VittorioCoseglia/OverDrive/img/multisim.PNG

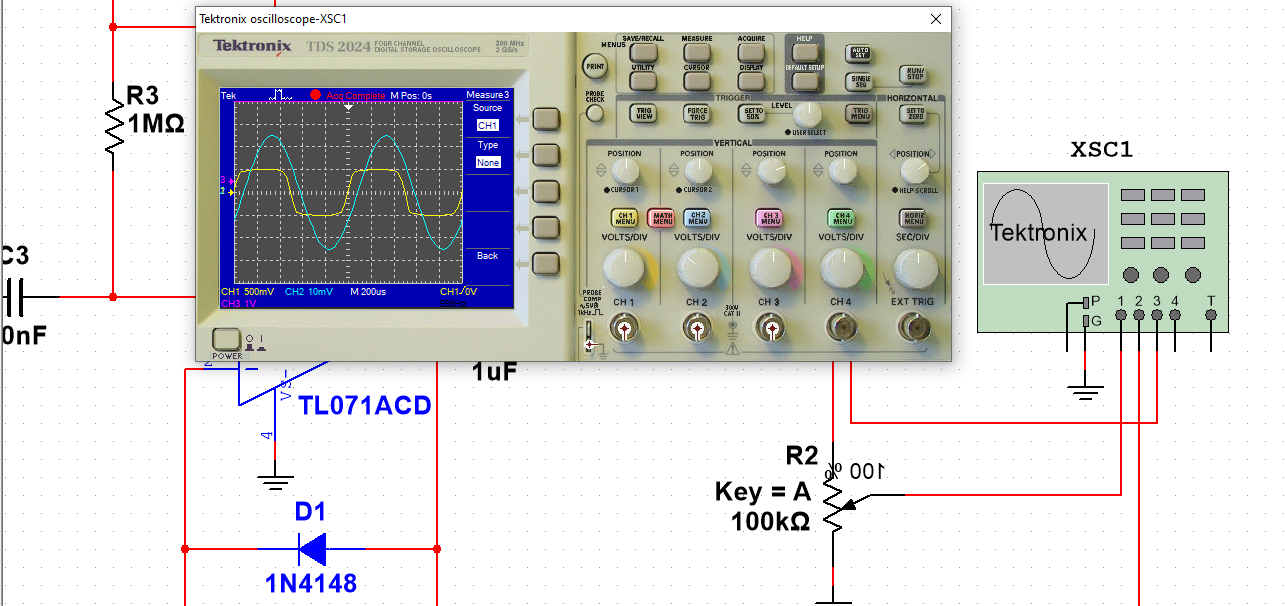
img/multisim.PNG
