VittorioCoseglia/OverDrive/docs/bom.md

# Bill of Materials 📑

> all of components are **THT**

_**The price factors in the quantity.**_
## Component List

| Reference | Qty | Value | Datasheet |
|---|---|---|---|
| 3PDT2 | 1 | 3PDT | |
| C1 | 1 | 470nF | |
| C2 | 1 | 1uF | |
| C3 | 1 | 220nF | |
| C4 | 1 | 100pF | |
| C5,C6 | 2 | 47uF | |
| D1 | 1 | LED | |
| D2,D3 | 2 | 1N4148 | [Datasheet](https://assets.nexperia.com/documents/data-sheet/1N4148_1N4448.pdf) |
| J1 | 1 | Barrel_Jack_MountingPin | |
| J2,J4 | 2 | NJ6TB-V | [Datasheet](https://www.neutrik.com/en/product/nj6tb-v) |
| R1 | 1 | 360 | |
| R2,R3,R6,R7 | 4 | 10k | |
| R4 | 1 | 1k | |
| R5 | 1 | 1M | |
| RV1 | 1 | LOG 100K | |
| RV2 | 1 | LOG 50K | |
| SW2 | 1 | 2pos_switch | [Datasheet](https://www.digikey.com/en/products/detail/c-k/OS102011MS2QS1/1981413) |
| U1 | 1 | TL071 | [Datasheet](http://www.ti.com/lit/ds/symlink/tl071.pdf) |
