VittorioCoseglia/OverDrive/Case/Pedal.step

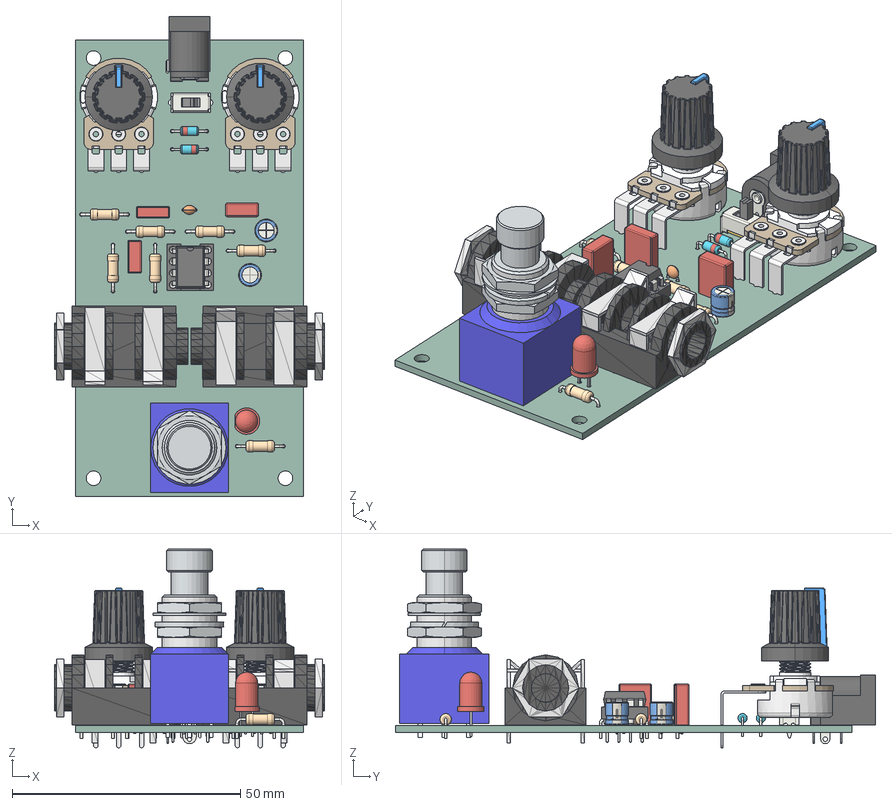
[picture p6: CAD file, 2026-10-29]
Case/Pedal.step
59.2 x 105.1 x 43.5 mm
Plastic_Body_1of2
Plastic_Body_2of2
PIN_01
PIN_03
PIN_02
Boner
NEUTRIKJK_2 x 2
NEUTRIKJK_3 x 2
NEUTRIKJK_4 x 2
NEUTRIKJK_5 x 2
NEUTRIKJK_6 x 2
NEUTRIKJK_7 x 2
NEUTRIKJK_8 x 2
NEUTRIKJK_9 x 2
NEUTRIKJK_10 x 2
NEUTRIKJK_11 x 2
NEUTRIKJK_12 x 2
NEUTRIKJK_13 x 2
NEUTRIKJK_14 x 2
NEUTRIKJK_15 x 2
NEUTRIKJK_16 x 2
NEUTRIKJK_17 x 2
NEUTRIKJK_18 x 2
NEUTRIKJK_19 x 2
NEUTRIKJK_20 x 2
NEUTRIKJK_21 x 2
NEUTRIKJK_22 x 2
NEUTRIKJK_23 x 2
NEUTRIKJK_24 x 2
NEUTRIKJK_25 x 2
NEUTRIKJK_26 x 2
R_Axial_DIN0207_L6.3mm_D2.5mm_P10.16mm_Horizontal x 7
D_DO-35_SOD27_P7.62mm_Horizontal x 2
User Library-Footswich_3PDT
CP_Radial_D5.0mm_P2.00mm x 2
C_Rect_L7.2mm_W2.5mm_P5.00mm_FKS2_FKP2_MKS2_MKP2
LED_D5.0mm
DIP-8_W7.62mm
DIP-8_W7.62mm_Socket
C_Rect_L7.2mm_W3.0mm_P5.00mm_FKS2_FKP2_MKS2_MKP2 x 2
RV16AF-41 x 2
knob x 2
C_Disc_D3.0mm_W2.0mm_P2.50mm
SW_Slide_SPDT_Straight_CK_OS102011MS2Q
Pedal_PCB
