VittorioCoseglia/OverDrive/PCB/3dmodels/knob.STEP

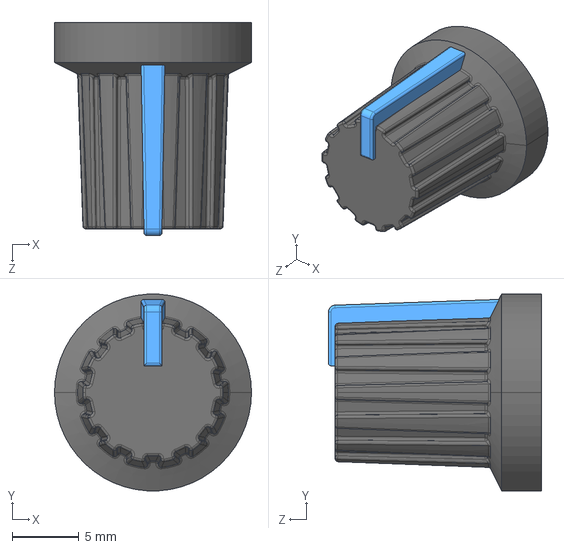
[picture p7: CAD file, 2026-10-29]
PCB/3dmodels/knob.STEP
14.8 x 14.8 x 16.0 mm
