VittorioCoseglia/OverDrive/Case/Case.STEP

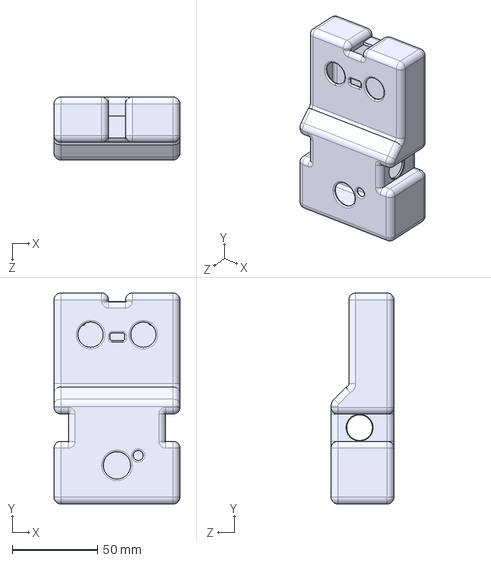
[picture p8: CAD file, 2026-10-29]
Case/Case.STEP
74.0 x 124.0 x 37.0 mm
