VittorioCoseglia/OverDrive/PCB/3dmodels/NEUTRIKJK.stp

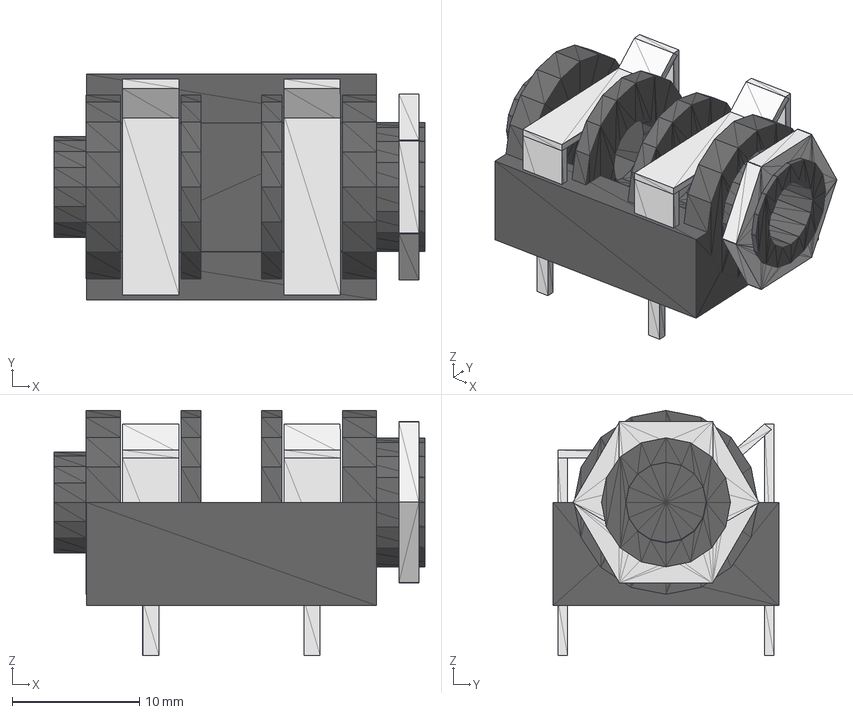
[picture p10: CAD file, 2026-10-29]
PCB/3dmodels/NEUTRIKJK.stp
29.2 x 17.8 x 19.3 mm
NEUTRIKJK_2
NEUTRIKJK_3
NEUTRIKJK_4
NEUTRIKJK_5
NEUTRIKJK_6
NEUTRIKJK_7
NEUTRIKJK_8
NEUTRIKJK_9
NEUTRIKJK_10
NEUTRIKJK_11
NEUTRIKJK_12
NEUTRIKJK_13
NEUTRIKJK_14
NEUTRIKJK_15
NEUTRIKJK_16
NEUTRIKJK_17
NEUTRIKJK_18
NEUTRIKJK_19
NEUTRIKJK_20
NEUTRIKJK_21
NEUTRIKJK_22
NEUTRIKJK_23
NEUTRIKJK_24
NEUTRIKJK_25
NEUTRIKJK_26
