VittorioCoseglia/OverDrive/PCB/3dmodels/User Library-Footswich_3PDT.step

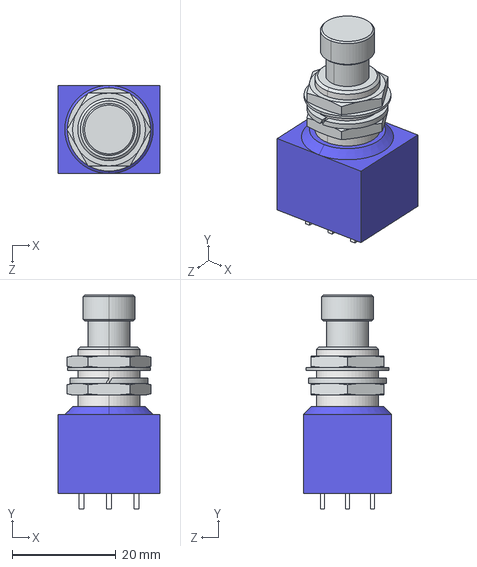
[picture p11: CAD file, 2026-10-29]
PCB/3dmodels/User Library-Footswich_3PDT.step
19.6 x 41.2 x 17.0 mm
