VittorioCoseglia/OverDrive/(list of files, cad)

Other CAD files:
Case/Case.SLDASM
Case/Case.SLDPRT
