VittorioCoseglia/OverDrive/PCB/Pedal.kicad_pcb

## KiCad design PCB/Pedal.kicad_pcb (2026-10-29)

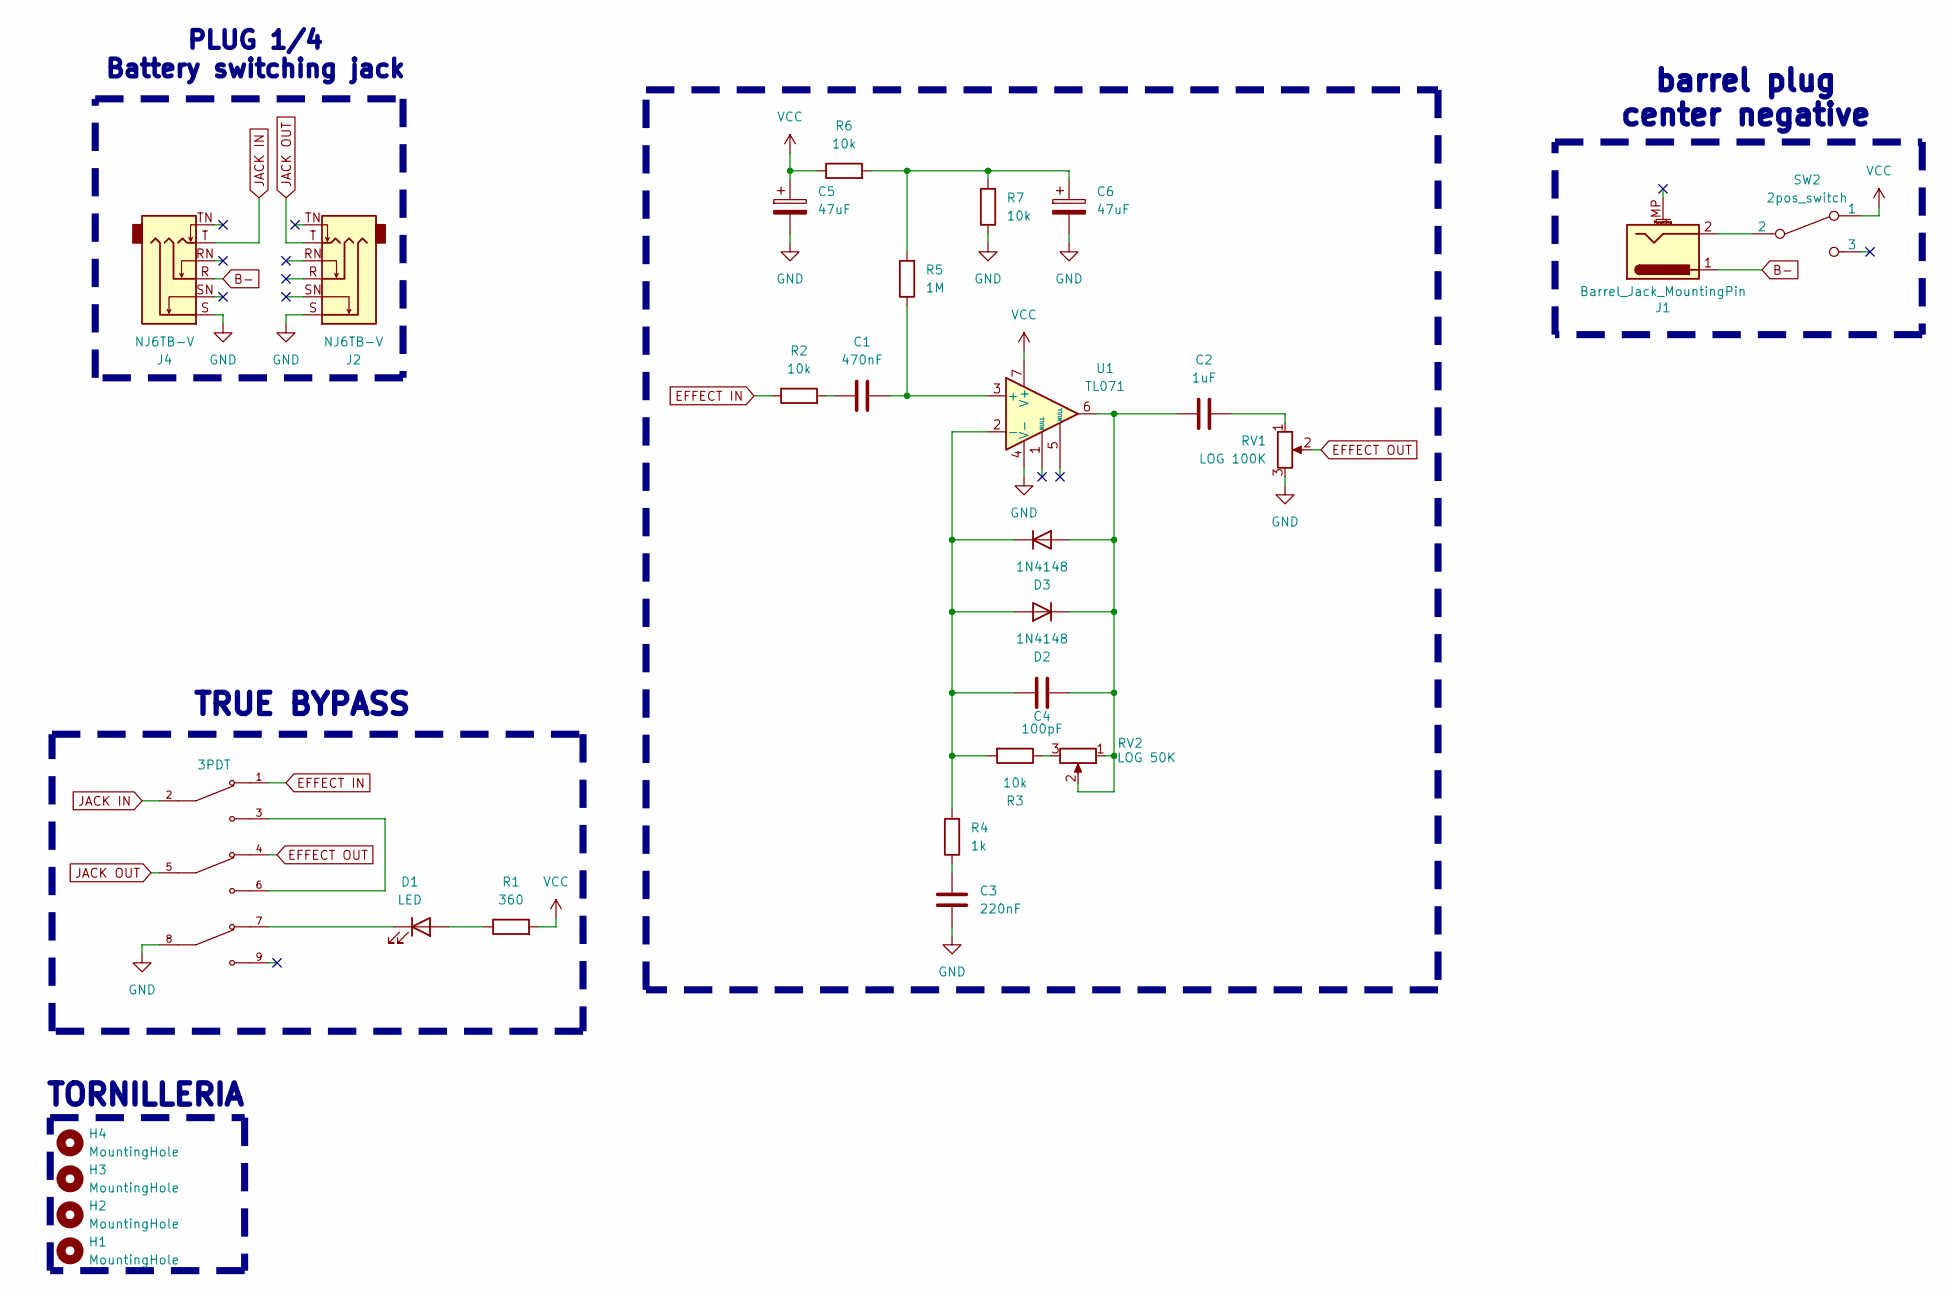
[picture p13: schematic Pedal.kicad_sch, OverDrive]

Parts:
3PDT2: 3PDT
C1: 470nF; C_Rect_L7.2mm_W3.0mm_P5.00mm_FKS2_FKP2_MKS2_MKP2
C2: 1uF; C_Rect_L7.2mm_W3.0mm_P5.00mm_FKS2_FKP2_MKS2_MKP2
C3: 220nF; C_Rect_L7.2mm_W2.5mm_P5.00mm_FKS2_FKP2_MKS2_MKP2
C4: 100pF; C_Disc_D3.0mm_W2.0mm_P2.50mm
C5, C6: 47uF; CP_Radial_D5.0mm_P2.00mm
D1: LED; LED_D5.0mm
D2, D3: 1N4148; D_DO-35_SOD27_P7.62mm_Horizontal
H1, H2, H3, H4: MountingHole; MountingHole_3.2mm_M3
J1: Barrel_Jack_MountingPin; DC_Power_Jack_PCB_Mounted_2.1mm
J2, J4: NJ6TB-V; Jack_6.35mm_Neutrik_NMJ6HFD4_Horizontal
R1: 360; R_Axial_DIN0207_L6.3mm_D2.5mm_P10.16mm_Horizontal
R2, R3, R6, R7: 10k; R_Axial_DIN0207_L6.3mm_D2.5mm_P10.16mm_Horizontal
R4: 1k; R_Axial_DIN0207_L6.3mm_D2.5mm_P10.16mm_Horizontal
R5: 1M; R_Axial_DIN0207_L6.3mm_D2.5mm_P10.16mm_Horizontal
RV1: LOG 100K; Potentiometer_Alps_RK163_Single_Horizontal
RV2: LOG 50K; Potentiometer_Alps_RK163_Single_Horizontal
SW2: 2pos_switch; SW_Slide_SPDT_Straight_CK_OS102011MS2Q
U1: TL071; DIP-8_W7.62mm_LongPads

Connections:
B-: J1.1, J4.R
EFFECT IN: 3PDT2.1, R2.1
EFFECT OUT: 3PDT2.4, RV1.2
GND: 3PDT2.8, C3.1, C5.2, C6.2, J2.S, J4.S, R7.1, RV1.3, U1.4 (V-)
JACK IN: 3PDT2.2, J4.T
JACK OUT: 3PDT2.5, J2.T
unnamed: 3PDT2.3, 3PDT2.6
unnamed: C1.1, R2.2
unnamed: C2.2, RV1.1
unnamed: C3.2, R4.1
unnamed: C6.1, R5.2, R6.2, R7.2
unnamed: D1.2 (A), R1.1
unnamed: 3PDT2.7, D1.1 (K)
unnamed: C4.1, D2.2 (A), D3.1 (K), R3.2, R4.2, U1.2 (-)
unnamed: C2.1, C4.2, D2.1 (K), D3.2 (A), RV2.1, RV2.2, U1.6
unnamed: J1.2, SW2.2
unnamed: R3.1, RV2.3
unnamed: C1.2, R5.1, U1.3 (+)
VCC: C5.1, R1.2, R6.1, SW2.1, U1.7 (V+)

Notes on the sheet:
barrel plug center negative
TORNILLERIA
PLUG 1/4 Battery switching jack
TRUE BYPASS

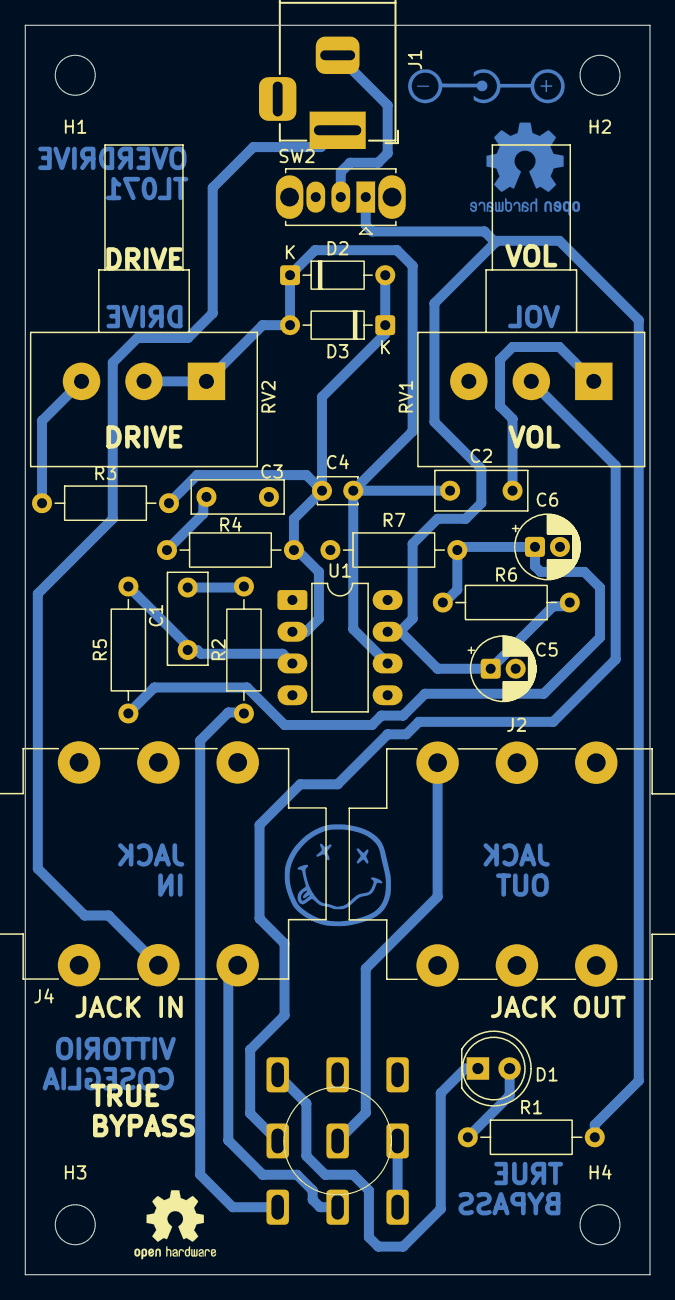
[picture p14: board Pedal.kicad_pcb from above]

Board: 2 copper layers, 50.0 x 100.0 mm, 28 parts (0 on the bottom side), 19 nets.
