VittorioCoseglia/OverDrive/(commit log)

2026-10-29 Kicad
    PCB/Schematic design
    [DC_Power_Jack_PCB_Mounted_2.1mm.step, NEUTRIKJK.stp, Pedal.kicad_pcb, Pedal.kicad_sch, RV16AF-41.step, User Library-Footswich_3PDT.step, knob.STEP]
2026-10-29 Change image extension from .png to .PNG
    Updated image file extension for the electronic schematic.
